Xilly-the-Honorable/beetledash/firmware_assets/beetle_front_worried.png

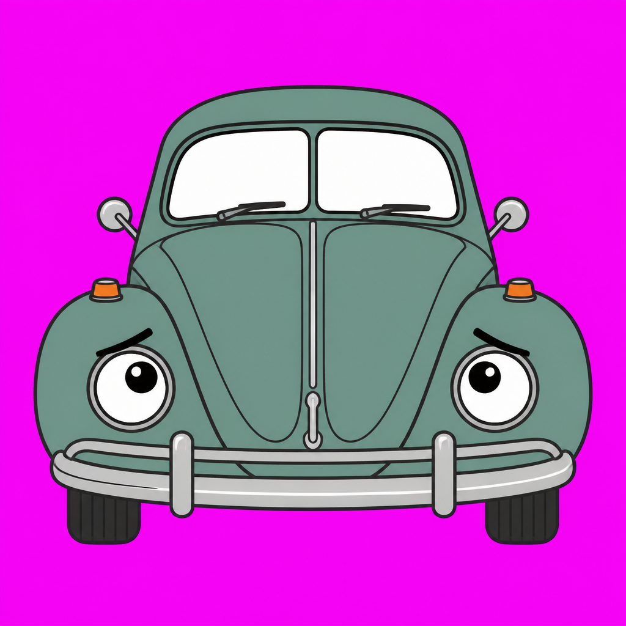
firmware_assets/beetle_front_worried.png
