Xilly-the-Honorable/beetledash/firmware_assets/beetle_lightning.png

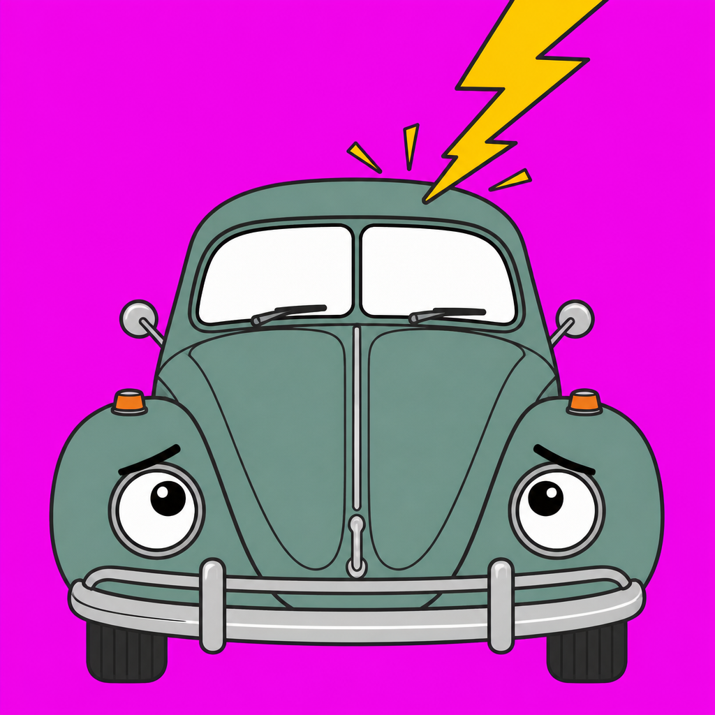
firmware_assets/beetle_lightning.png
