Xilly-the-Honorable/beetledash/firmware_assets/kienzle_face.png

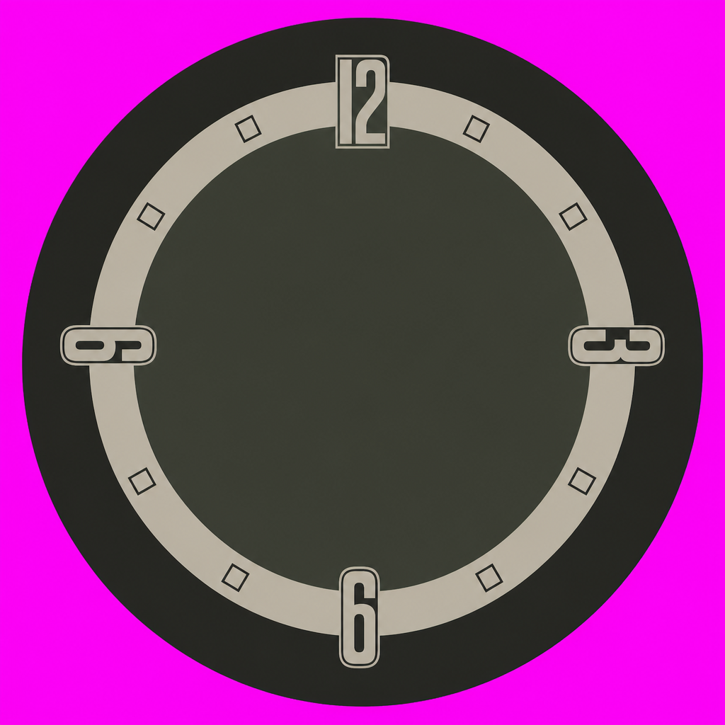
firmware_assets/kienzle_face.png
