Xilly-the-Honorable/beetledash/firmware/BeetleDash_V2_display/Gauge_UI.cpp

#include "Gauge_UI.h"
#include "Config.h"
#include <lvgl.h>
#include <math.h>
#include <esp_heap_caps.h>

extern const lv_img_dsc_t beetle_icon;          // beetle_icon.c (A8 silhouette, recolored at runtime)
extern const lv_img_dsc_t beetle_front_worried; // beetle_front_worried.c (low-fuel alert mascot)
extern const lv_img_dsc_t beetle_lightning;     // beetle_lightning.c (low-voltage alert mascot)
extern const lv_img_dsc_t kienzle_face;         // kienzle_face.c (pre-rendered Kienzle clock face)

// ---------- Palette: 1965 VW/VDO instrument family (docs/V3_vintage_ui_brief.md §0) ----------
#define COL_FACE      0x141414   // matte near-black gauge face
#define COL_BEZEL     0xC9CDD1   // chrome outer ring
#define COL_BEZEL_SHD 0x5A5E62   // thin inner shadow ring
#define COL_CREAM     0xEDE6D6   // aged-white markings/needles (never pure white)
#define COL_SAGE      0xC9CFC0   // classic VDO grey-green numerals
#define COL_FAINT     0x6B6B60   // dimmed cream for secondary text
#define COL_TRACK     0x2A2A26   // unlit scale track
#define COL_RED       0xB3352C   // vintage red (muted)
#define COL_AMBER     0xC98A2C   // muted amber
#define COL_GREEN     0x3E6B4F   // muted green band
#define COL_ORANGE    0xE8930C   // instrument orange (compass only)
#define COL_YELLOW    0xE8C43C   // amber/yellow cardinal letters
#define COL_HUB_SILVER 0xB9BDC1  // speedo-style silver hub cap
#define COL_HUB_DARK  0x1A1A1A   // volt-style dark hub cap
#define COL_DOT_OFF   0x3A3A3A   // inactive page dot

// Legacy aliases used by the not-yet-restyled screens (removed as milestones land)
#define COL_BG      COL_FACE
#define COL_CARD    COL_TRACK
#define COL_TEXT    COL_CREAM
#define COL_MUTED   COL_SAGE

#define BEZEL_W       8          // chrome ring width
#define BEZEL_SHD_W   6          // shadow ring width

#define SCREEN_COUNT 6

static gauge_data_provider_t dataProvider = NULL;

static lv_obj_t *tileview;
static lv_obj_t *dots[SCREEN_COUNT];

// Fuel screen (Störk-style round dial, dual liters/gallons scale)
static lv_obj_t *fuelMeter, *fuelDigital, *fuelAlert;
static lv_obj_t *fuelEyeL, *fuelEyeR;    // blinking headlight overlays on the mascot
static lv_meter_indicator_t *fuelNeedleL, *fuelNeedleR;   // two ends of one center-pivot needle
static lv_meter_scale_t *fuelScaleL, *fuelScaleGal;
#define COL_MINT 0xA8D4A0   // pale Störk green (markings, numerals, needle)
#define FUEL_ALERT_BELOW 25.0f   // show the "LOW FUEL" alert under this %
#define COL_LAMP  0xFFD84A       // lit-headlight yellow (alert only)
// Speed screen (VDO speedometer)
static lv_obj_t *speedMeter, *speedDigital, *speedSats;
static lv_meter_indicator_t *speedNeedle;
// Volts screen (VDO voltmeter)
static lv_obj_t *voltMeter, *voltDigital, *voltAlert;
static lv_meter_indicator_t *voltNeedle;
// Clock screen (vintage VDO dash clock)
static lv_obj_t *clockMeter, *clockValue, *clockSub;
static lv_meter_indicator_t *clockHourHand, *clockMinHand;
// Compass screen (aviation direction indicator)
static lv_obj_t *compassCard, *compassReadout;
// Brakes screen (dual-circuit status)
static lv_obj_t *brakeLamp1, *brakeLamp2, *brakeVerdict, *brakeVerdictLabel, *brakeSubLabel;

static const char *CARDINALS[8] = {"N", "NE", "E", "SE", "S", "SW", "W", "NW"};

// ============================================================
//  Small helpers
// ============================================================
// Tile indices (order of make_tile calls in Gauge_UI_Init)
#define TILE_FUEL    0
#define TILE_SPEED   1
#define TILE_VOLTS   2
#define TILE_CLOCK   3
#define TILE_COMPASS 4
#define TILE_BRAKES  5

// Alerts call this on their rising edge so the screen jumps to the gauge that
// raised them (the user can still swipe away while the alert stays up).
static void jump_to_tile(int idx)
{
  lv_obj_set_tile_id(tileview, idx, 0, LV_ANIM_OFF);
}

// Tap anywhere on a gauge -> jump to the next screen (wraps around).
// A drag still swipes: LVGL suppresses CLICKED once a gesture turns into a scroll.
// No animation: a single redraw beats the sluggish full-screen scroll on this panel.
static void tile_tap_cb(lv_event_t *e)
{
  int idx = (int)(intptr_t)lv_event_get_user_data(e);
  lv_obj_set_tile_id(tileview, (idx + 1) % SCREEN_COUNT, 0, LV_ANIM_OFF);
}

static lv_obj_t *make_tile(int idx)
{
  lv_obj_t *tile = lv_tileview_add_tile(tileview, idx, 0, LV_DIR_HOR);
  lv_obj_set_style_bg_color(tile, lv_color_hex(COL_BG), 0);
  lv_obj_set_style_bg_opa(tile, LV_OPA_COVER, 0);
  lv_obj_add_event_cb(tile, tile_tap_cb, LV_EVENT_CLICKED, (void *)(intptr_t)idx);
  return tile;
}

static lv_obj_t *make_label(lv_obj_t *parent, const lv_font_t *font, uint32_t color,
                            lv_align_t align, lv_coord_t x, lv_coord_t y, const char *text)
{
  lv_obj_t *l = lv_label_create(parent);
  lv_obj_set_style_text_font(l, font, 0);
  lv_obj_set_style_text_color(l, lv_color_hex(color), 0);
  lv_label_set_text(l, text);
  lv_obj_align(l, align, x, y);
  return l;
}

// Plain circle (used for bezel rings, hubs, markers)
static lv_obj_t *make_circle(lv_obj_t *parent, lv_coord_t d, uint32_t fill)
{
  lv_obj_t *c = lv_obj_create(parent);
  lv_obj_set_size(c, d, d);
  lv_obj_set_style_radius(c, LV_RADIUS_CIRCLE, 0);
  lv_obj_set_style_bg_color(c, lv_color_hex(fill), 0);
  lv_obj_set_style_bg_opa(c, LV_OPA_COVER, 0);
  lv_obj_set_style_border_width(c, 0, 0);
  lv_obj_set_style_pad_all(c, 0, 0);
  lv_obj_clear_flag(c, LV_OBJ_FLAG_CLICKABLE | LV_OBJ_FLAG_SCROLLABLE);
  lv_obj_center(c);
  return c;
}

// Chrome bezel: outer chrome ring -> thin shadow ring -> matte face.
// Concentric filled circles, drawn once, everything else goes on top.
static void make_bezel(lv_obj_t *tile)
{
  make_circle(tile, LV_HOR_RES, COL_BEZEL);
  make_circle(tile, LV_HOR_RES - 2 * BEZEL_W, COL_BEZEL_SHD);
  make_circle(tile, LV_HOR_RES - 2 * (BEZEL_W + BEZEL_SHD_W), COL_FACE);
}

// Letter-spaced caption ("TANK", "VOLTS", "MPH", ...)
static lv_obj_t *make_caption(lv_obj_t *parent, const char *text, lv_align_t align,
                              lv_coord_t x, lv_coord_t y)
{
  lv_obj_t *l = make_label(parent, &lv_font_montserrat_20, COL_CREAM, align, x, y, text);
  lv_obj_set_style_text_letter_space(l, 6, 0);
  return l;
}

// Tiny period wordmark near the bottom of every face
static void make_wordmark(lv_obj_t *tile)
{
  lv_obj_t *l = make_label(tile, &lv_font_montserrat_12, COL_FAINT,
                           LV_ALIGN_BOTTOM_MID, 0, -52, "BEETLEDASH");
  lv_obj_set_style_text_letter_space(l, 4, 0);
}

// Digital readout color state: muted red low, cream normal, muted amber high.
static uint32_t volt_text_color(float v)
{
  if (v < VOLT_LOW_BELOW)  return COL_RED;
  if (v > VOLT_HIGH_ABOVE) return COL_AMBER;
  return COL_CREAM;
}

// Bare meter: no background, no border — just scale, ticks, and needle.
static lv_obj_t *make_bare_meter(lv_obj_t *parent, lv_coord_t size)
{
  lv_obj_t *m = lv_meter_create(parent);
  lv_obj_set_size(m, size, size);
  lv_obj_set_style_bg_opa(m, LV_OPA_TRANSP, 0);
  lv_obj_set_style_border_width(m, 0, 0);
  lv_obj_set_style_pad_all(m, 0, 0);
  lv_obj_clear_flag(m, LV_OBJ_FLAG_CLICKABLE | LV_OBJ_FLAG_SCROLLABLE);
  return m;
}

// Needle hub: volt-style dark cap with a thin chrome edge, or silver speedo cap.
static void make_hub(lv_obj_t *tile, lv_coord_t d, lv_coord_t x, lv_coord_t y, bool silver)
{
  lv_obj_t *hub = make_circle(tile, d, silver ? COL_HUB_SILVER : COL_HUB_DARK);
  if (!silver) {
    lv_obj_set_style_border_width(hub, 2, 0);
    lv_obj_set_style_border_color(hub, lv_color_hex(COL_BEZEL), 0);
  }
  lv_obj_align(hub, LV_ALIGN_CENTER, x, y);
}

// ============================================================
//  Screen builders
// ============================================================
// Störk-style fuel gauge (per the dual °C/°F oil gauge reference): the needle
// is a full diameter line pivoting at DEAD CENTER, and its two ends read two
// mirrored half-scales — LITERS on the left (40 L at bottom-left when full,
// 0 L at top-left) and US GALLONS on the right (full = 10.6 gal at top-right,
// 0 at bottom-right). Implemented as two 180°-opposed needle indicators on
// hidden scales, driven together. The visible tick scales run "reversed"
// (values increase clockwise) so labels are rewritten in the draw callback.
static void fuel_tick_cb(lv_event_t *e)
{
  lv_obj_draw_part_dsc_t *dsc = lv_event_get_draw_part_dsc(e);
  if (dsc->type != LV_METER_DRAW_PART_TICK || !dsc->text) return;

  static char buf[8];
  if (dsc->sub_part_ptr == fuelScaleGal)
    lv_snprintf(buf, sizeof(buf), "%d", 10 - (int)dsc->value / 2);   // half-gallon units
  else
    lv_snprintf(buf, sizeof(buf), "%d", 40 - (int)dsc->value);       // liters
  dsc->text = buf;
}

static void build_fuel(lv_obj_t *tile)
{
  make_bezel(tile);
  lv_obj_t *cap = make_label(tile, &lv_font_montserrat_24, COL_MINT,
                             LV_ALIGN_CENTER, 0, -120, "TANK");
  lv_obj_set_style_text_letter_space(cap, 6, 0);

  fuelMeter = make_bare_meter(tile, 430);
  lv_obj_center(fuelMeter);

  lv_obj_set_style_text_font(fuelMeter, &lv_font_montserrat_24, LV_PART_TICKS);
  lv_obj_set_style_text_color(fuelMeter, lv_color_hex(COL_MINT), LV_PART_TICKS);
  lv_obj_add_event_cb(fuelMeter, fuel_tick_cb, LV_EVENT_DRAW_PART_BEGIN, NULL);

  // LEFT half — liters. Bottom-left (135°) to top-left (225°); tick values
  // 0..40 clockwise, labels reversed to 40..0 so 40 L sits at bottom-left.
  // Minors every 2 L, majors every 10 L.
  fuelScaleL = lv_meter_add_scale(fuelMeter);
  lv_meter_set_scale_range(fuelMeter, fuelScaleL, 0, 40, 90, 135);
  lv_meter_set_scale_ticks(fuelMeter, fuelScaleL, 21, 3, 14, lv_color_hex(COL_MINT));
  lv_meter_set_scale_major_ticks(fuelMeter, fuelScaleL, 5, 5, 24, lv_color_hex(COL_MINT), 24);

  // RIGHT half — gallons, whole numbers only. Full tank = 10.6 gal at
  // top-right (315°), empty at bottom-right (45°). The integer ticks 10..0
  // occupy 90° * 10/10.6 ≈ 85°, starting at 320° (the "10" mark sits just
  // shy of where the full needle points). Values in half-gallons (0..20
  // clockwise), labels reversed. Minors every 0.5 gal, majors every 2 gal.
  fuelScaleGal = lv_meter_add_scale(fuelMeter);
  lv_meter_set_scale_range(fuelMeter, fuelScaleGal, 0, 20, 85, 320);
  lv_meter_set_scale_ticks(fuelMeter, fuelScaleGal, 21, 3, 14, lv_color_hex(COL_MINT));
  lv_meter_set_scale_major_ticks(fuelMeter, fuelScaleGal, 4, 5, 24, lv_color_hex(COL_MINT), 24);

  // Red reserve wedge on the liters side (last ~12% ≈ under 5 L, near top-left)
  lv_meter_indicator_t *reserve = lv_meter_add_arc(fuelMeter, fuelScaleL, 6, lv_color_hex(COL_RED), 0);
  lv_meter_set_indicator_start_value(fuelMeter, reserve, 35);
  lv_meter_set_indicator_end_value(fuelMeter, reserve, 40);

  // Needle = two ends of one center-pivot line, on hidden 0..1000 (permille,
  // empty..full reversed) scales 180° apart. Value 0 = full, 1000 = empty.
  lv_meter_scale_t *nL = lv_meter_add_scale(fuelMeter);
  lv_meter_set_scale_range(fuelMeter, nL, 0, 1000, 90, 135);   // full: bottom-left
  lv_meter_set_scale_ticks(fuelMeter, nL, 0, 0, 0, lv_color_black());
  lv_meter_scale_t *nR = lv_meter_add_scale(fuelMeter);
  lv_meter_set_scale_range(fuelMeter, nR, 0, 1000, 90, 315);   // full: top-right
  lv_meter_set_scale_ticks(fuelMeter, nR, 0, 0, 0, lv_color_black());
  fuelNeedleL = lv_meter_add_needle_line(fuelMeter, nL, 5, lv_color_hex(COL_MINT), -14);
  fuelNeedleR = lv_meter_add_needle_line(fuelMeter, nR, 5, lv_color_hex(COL_MINT), -14);
  lv_meter_set_indicator_value(fuelMeter, fuelNeedleL, 1000);
  lv_meter_set_indicator_value(fuelMeter, fuelNeedleR, 1000);

  make_hub(tile, 44, 0, 0, false);                            // black cap, chrome edge

  // Unit labels under each half-scale, like the °C / °F on the original
  make_label(tile, &lv_font_montserrat_16, COL_MINT, LV_ALIGN_CENTER, -118, 148, "L");
  make_label(tile, &lv_font_montserrat_16, COL_MINT, LV_ALIGN_CENTER, 118, 148, "GAL");
  // Liters remaining, below the hub
  fuelDigital = make_label(tile, &lv_font_montserrat_24, COL_MINT, LV_ALIGN_CENTER, 0, 78, "-- L");

  // "LOW FUEL" alert: yellow panel, dark text, worried beetle — replaces the
  // digital liters readout when low (same styling as the low-voltage alert).
  fuelAlert = lv_obj_create(tile);
  lv_obj_set_size(fuelAlert, LV_SIZE_CONTENT, LV_SIZE_CONTENT);
  lv_obj_set_style_bg_color(fuelAlert, lv_color_hex(COL_YELLOW), 0);
  lv_obj_set_style_bg_opa(fuelAlert, LV_OPA_COVER, 0);
  lv_obj_set_style_radius(fuelAlert, 18, 0);
  lv_obj_set_style_border_width(fuelAlert, 0, 0);
  lv_obj_set_style_pad_all(fuelAlert, 14, 0);
  lv_obj_set_style_pad_column(fuelAlert, 14, 0);
  lv_obj_set_flex_flow(fuelAlert, LV_FLEX_FLOW_ROW);
  lv_obj_set_flex_align(fuelAlert, LV_FLEX_ALIGN_CENTER, LV_FLEX_ALIGN_CENTER, LV_FLEX_ALIGN_CENTER);
  lv_obj_clear_flag(fuelAlert, LV_OBJ_FLAG_CLICKABLE | LV_OBJ_FLAG_SCROLLABLE);

  lv_obj_t *alertText = lv_label_create(fuelAlert);
  lv_obj_set_style_text_font(alertText, &lv_font_montserrat_32, 0);
  lv_obj_set_style_text_color(alertText, lv_color_hex(COL_FACE), 0);   // dark on yellow
  lv_obj_set_style_text_letter_space(alertText, 2, 0);
  lv_label_set_text(alertText, "LOW\nFUEL");

  lv_obj_t *worried = lv_img_create(fuelAlert);
  lv_img_set_src(worried, &beetle_front_worried);

  // Headlight "flashers": yellow circles over the eyes (centers ~(22,63) and
  // (100,63) in the 122x100 art), blinked from refresh_cb while the alert shows.
  fuelEyeL = make_circle(worried, 20, COL_LAMP);
  fuelEyeR = make_circle(worried, 20, COL_LAMP);
  lv_obj_align(fuelEyeL, LV_ALIGN_TOP_LEFT, 12, 53);
  lv_obj_align(fuelEyeR, LV_ALIGN_TOP_LEFT, 90, 53);
  lv_obj_t *eyes[2] = { fuelEyeL, fuelEyeR };
  for (int i = 0; i < 2; i++) {
    lv_obj_set_style_border_width(eyes[i], 3, 0);
    lv_obj_set_style_border_color(eyes[i], lv_color_hex(COL_ORANGE), 0);
    lv_obj_set_style_opa(eyes[i], LV_OPA_TRANSP, 0);   // start dark
  }

  lv_obj_align(fuelAlert, LV_ALIGN_CENTER, 0, 6);
  lv_obj_add_flag(fuelAlert, LV_OBJ_FLAG_HIDDEN);

  make_wordmark(tile);
}

// 1965 VDO speedometer: 0–80 sage numerals, 0 at ~7 o'clock sweeping clockwise
// to 80 at ~5 o'clock, long cream needle on a silver hub.
static void build_speed(lv_obj_t *tile)
{
  make_bezel(tile);

  speedMeter = make_bare_meter(tile, 430);
  lv_obj_center(speedMeter);

  lv_meter_scale_t *sc = lv_meter_add_scale(speedMeter);
  lv_meter_set_scale_range(speedMeter, sc, 0, 80, 270, 135);    // 0 @ 7 o'clock → 80 @ 5 o'clock
  lv_meter_set_scale_ticks(speedMeter, sc, 17, 3, 14, lv_color_hex(COL_CREAM));      // every 5 mph
  lv_meter_set_scale_major_ticks(speedMeter, sc, 2, 6, 26, lv_color_hex(COL_CREAM), 24); // every 10
  lv_obj_set_style_text_font(speedMeter, &lv_font_montserrat_28, LV_PART_TICKS);
  lv_obj_set_style_text_color(speedMeter, lv_color_hex(COL_SAGE), LV_PART_TICKS);    // sage numerals

  speedNeedle = lv_meter_add_needle_line(speedMeter, sc, 6, lv_color_hex(COL_CREAM), -14);
  lv_meter_set_indicator_value(speedMeter, speedNeedle, 0);

  make_hub(tile, 64, 0, 0, true);                               // silver speedo hub
  make_caption(tile, "MPH", LV_ALIGN_CENTER, 0, 72);
  speedDigital = make_label(tile, &lv_font_montserrat_28, COL_CREAM, LV_ALIGN_CENTER, 0, 118, "--");
  speedSats = make_label(tile, &lv_font_montserrat_14, COL_FAINT, LV_ALIGN_CENTER, 0, 152, "acquiring fix...");
  make_wordmark(tile);
}

// VDO voltmeter: 8–16 V scale (decivolt units internally), colored bands on the
// arc, needle from a lower-center pivot, live digital readout under the hub.
static void volt_tick_label_cb(lv_event_t *e)
{
  lv_obj_draw_part_dsc_t *dsc = lv_event_get_draw_part_dsc(e);
  if (dsc->type != LV_METER_DRAW_PART_TICK || dsc->text == NULL) return;
  static char buf[8];                       // LVGL draws each label before the next event
  lv_snprintf(buf, sizeof(buf), "%d", (int)(dsc->value / 10));
  dsc->text = buf;
}

static void build_volts(lv_obj_t *tile)
{
  make_bezel(tile);

  const lv_coord_t msize = 540, pivotY = 340;
  voltMeter = make_bare_meter(tile, msize);
  lv_obj_set_pos(voltMeter, 240 - msize / 2, pivotY - msize / 2);

  lv_meter_scale_t *sc = lv_meter_add_scale(voltMeter);
  lv_meter_set_scale_range(voltMeter, sc, 80, 160, 120, 210);   // 8–16 V over 120° up top
  lv_meter_set_scale_ticks(voltMeter, sc, 9, 3, 16, lv_color_hex(COL_CREAM));        // every 1 V
  lv_meter_set_scale_major_ticks(voltMeter, sc, 2, 6, 28, lv_color_hex(COL_CREAM), 28); // 8·10·12·14·16
  lv_obj_set_style_text_font(voltMeter, &lv_font_montserrat_24, LV_PART_TICKS);
  lv_obj_set_style_text_color(voltMeter, lv_color_hex(COL_CREAM), LV_PART_TICKS);
  lv_obj_add_event_cb(voltMeter, volt_tick_label_cb, LV_EVENT_DRAW_PART_BEGIN, NULL);

  // Colored bands on the scale arc (like the reference): red 8–10.5,
  // amber transition 10.5–11.5, muted green 11.5–16.
  struct { int from, to; uint32_t col; } bands[] = {
    {80, 105, COL_RED}, {105, 115, COL_AMBER}, {115, 160, COL_GREEN},
  };
  for (auto &b : bands) {
    lv_meter_indicator_t *arc = lv_meter_add_arc(voltMeter, sc, 10, lv_color_hex(b.col), 0);
    lv_meter_set_indicator_start_value(voltMeter, arc, b.from);
    lv_meter_set_indicator_end_value(voltMeter, arc, b.to);
  }

  voltNeedle = lv_meter_add_needle_line(voltMeter, sc, 6, lv_color_hex(COL_CREAM), -36);
  lv_meter_set_indicator_value(voltMeter, voltNeedle, 120);

  make_hub(tile, 56, 0, pivotY - 240, false);
  make_caption(tile, "VOLTS", LV_ALIGN_CENTER, 78, -24);        // right-of-center, like the reference

  // Live digital readout under the hub — hard requirement.
  voltDigital = make_label(tile, &lv_font_montserrat_28, COL_CREAM, LV_ALIGN_CENTER, 0, 150, "--.-");
  make_label(tile, &lv_font_montserrat_14, COL_FAINT, LV_ALIGN_CENTER, 52, 154, "V");

  // "LOW VOLTAGE" alert: yellow panel, dark text, lightning-struck beetle.
  // Suppressed for the first minute after boot (startup voltage sag).
  voltAlert = lv_obj_create(tile);
  lv_obj_set_size(voltAlert, LV_SIZE_CONTENT, LV_SIZE_CONTENT);
  lv_obj_set_style_bg_color(voltAlert, lv_color_hex(COL_YELLOW), 0);
  lv_obj_set_style_bg_opa(voltAlert, LV_OPA_COVER, 0);
  lv_obj_set_style_radius(voltAlert, 18, 0);
  lv_obj_set_style_border_width(voltAlert, 0, 0);
  lv_obj_set_style_pad_all(voltAlert, 14, 0);
  lv_obj_set_style_pad_column(voltAlert, 14, 0);
  lv_obj_set_flex_flow(voltAlert, LV_FLEX_FLOW_ROW);
  lv_obj_set_flex_align(voltAlert, LV_FLEX_ALIGN_CENTER, LV_FLEX_ALIGN_CENTER, LV_FLEX_ALIGN_CENTER);
  lv_obj_clear_flag(voltAlert, LV_OBJ_FLAG_CLICKABLE | LV_OBJ_FLAG_SCROLLABLE);

  lv_obj_t *vText = lv_label_create(voltAlert);
  lv_obj_set_style_text_font(vText, &lv_font_montserrat_32, 0);
  lv_obj_set_style_text_color(vText, lv_color_hex(COL_FACE), 0);   // dark on yellow
  lv_obj_set_style_text_letter_space(vText, 2, 0);
  lv_label_set_text(vText, "LOW\nVOLTAGE");

  lv_obj_t *struck = lv_img_create(voltAlert);
  lv_img_set_src(struck, &beetle_lightning);

  lv_obj_align(voltAlert, LV_ALIGN_CENTER, 0, -10);
  lv_obj_add_flag(voltAlert, LV_OBJ_FLAG_HIDDEN);
  make_wordmark(tile);
}

// Kienzle-style VW dash clock: the face (ring band, sideways 3/9, deco
// numerals, square hour markers) is a pre-rendered bitmap generated from the
// reference photos — LVGL can't rotate label glyphs, and the sideways quarter
// numerals are the signature of this clock. Hands, hub and the digital HH:MM
// (in the "8 TAGE" spot) are still drawn live on top.
#define COL_BRASS 0xC5A05A   // gold-brass hands

static void build_clock(lv_obj_t *tile)
{
  make_bezel(tile);

  lv_obj_t *face = lv_img_create(tile);
  lv_img_set_src(face, &kienzle_face);
  lv_obj_center(face);

  // Meter only carries the two hands (scales invisible)
  clockMeter = make_bare_meter(tile, 430);
  lv_obj_center(clockMeter);
  lv_meter_scale_t *scMin = lv_meter_add_scale(clockMeter);
  lv_meter_set_scale_range(clockMeter, scMin, 0, 60, 360, 270);   // 0 (=12) at the top
  lv_meter_set_scale_ticks(clockMeter, scMin, 0, 0, 0, lv_color_black());
  lv_meter_scale_t *scHour = lv_meter_add_scale(clockMeter);     // smooth hour hand
  lv_meter_set_scale_range(clockMeter, scHour, 0, 720, 360, 270);
  lv_meter_set_scale_ticks(clockMeter, scHour, 0, 0, 0, lv_color_black());

  // Tips sized to the bitmap face: minute reaches into the ring band
  // (~r145), hour stops short of the numerals (~r105).
  clockMinHand  = lv_meter_add_needle_line(clockMeter, scMin,  5, lv_color_hex(COL_BRASS), -67);
  clockHourHand = lv_meter_add_needle_line(clockMeter, scHour, 8, lv_color_hex(COL_BRASS), -110);
  lv_meter_set_indicator_value(clockMeter, clockMinHand, 0);
  lv_meter_set_indicator_value(clockMeter, clockHourHand, 0);

  make_hub(tile, 32, 0, 0, false);

  // Digital HH:MM in the "8 TAGE" spot; GPS status line mirrored above the hub
  clockValue = make_label(tile, &lv_font_montserrat_20, COL_CREAM, LV_ALIGN_CENTER, 0, 88, "--:--");
  lv_obj_set_style_text_letter_space(clockValue, 3, 0);
  clockSub = make_label(tile, &lv_font_montserrat_14, COL_FAINT, LV_ALIGN_CENTER, 0, -92, "waiting for GPS time");
  make_wordmark(tile);
}

// Aviation direction indicator: the card (ticks + numerals + cardinals) is drawn
// ONCE onto a canvas in PSRAM, then rotated as a whole with lv_img_set_angle()
// (card angle = -heading). The beetle icon and lubber line stay fixed on top.
#define CARD_SIZE 420
#define CARD_C    (CARD_SIZE / 2)

static void draw_compass_card(lv_obj_t *canvas)
{
  lv_canvas_fill_bg(canvas, lv_color_black(), LV_OPA_TRANSP);

  lv_draw_line_dsc_t ld;
  lv_draw_line_dsc_init(&ld);
  ld.color = lv_color_hex(COL_CREAM);

  for (int deg = 0; deg < 360; deg += 5) {
    bool major = (deg % 10) == 0;
    ld.width = major ? 3 : 2;
    float a = deg * (float)M_PI / 180.0f;
    float sx = sinf(a), cy = -cosf(a);
    lv_coord_t r1 = CARD_C - 2, r2 = CARD_C - (major ? 22 : 13);
    lv_point_t pts[2] = {
      { (lv_coord_t)(CARD_C + r1 * sx), (lv_coord_t)(CARD_C + r1 * cy) },
      { (lv_coord_t)(CARD_C + r2 * sx), (lv_coord_t)(CARD_C + r2 * cy) },
    };
    lv_canvas_draw_line(canvas, pts, 2, &ld);
  }

  // Numerals every 30°: N/E/S/W in amber at the cardinals, tens-of-degrees
  // (3, 6, 12, 15, 21, 24, 30, 33) in cream between them.
  lv_draw_label_dsc_t td;
  lv_draw_label_dsc_init(&td);
  td.align = LV_TEXT_ALIGN_CENTER;
  const lv_coord_t rText = CARD_C - 52;
  for (int i = 0; i < 12; i++) {
    int deg = i * 30;
    bool cardinal = (deg % 90) == 0;
    td.font  = cardinal ? &lv_font_montserrat_28 : &lv_font_montserrat_24;
    td.color = lv_color_hex(cardinal ? COL_YELLOW : COL_CREAM);
    char buf[4];
    if (cardinal) buf[0] = "NESW"[deg / 90], buf[1] = '\0';
    else          lv_snprintf(buf, sizeof(buf), "%d", deg / 10);
    float a = deg * (float)M_PI / 180.0f;
    lv_coord_t x = (lv_coord_t)(CARD_C + rText * sinf(a));
    lv_coord_t y = (lv_coord_t)(CARD_C - rText * cosf(a));
    lv_canvas_draw_text(canvas, x - 40, y - 16, 80, &td, buf);
  }
}

static void build_compass(lv_obj_t *tile)
{
  make_bezel(tile);

  // Card canvas lives in PSRAM (ARGB, ~530 KB) — drawn once, rotated per update.
  static lv_color_t *cardBuf = NULL;
  if (cardBuf == NULL)
    cardBuf = (lv_color_t *)heap_caps_malloc(
        LV_CANVAS_BUF_SIZE_TRUE_COLOR_ALPHA(CARD_SIZE, CARD_SIZE), MALLOC_CAP_SPIRAM);

  compassCard = lv_canvas_create(tile);
  lv_canvas_set_buffer(compassCard, cardBuf, CARD_SIZE, CARD_SIZE, LV_IMG_CF_TRUE_COLOR_ALPHA);
  lv_obj_center(compassCard);
  draw_compass_card(compassCard);
  lv_img_set_pivot(compassCard, CARD_C, CARD_C);

  // Fixed beetle silhouette, instrument orange, nose up — the card turns around it.
  lv_obj_t *ic = lv_img_create(tile);
  lv_img_set_src(ic, &beetle_icon);
  lv_obj_set_style_img_recolor(ic, lv_color_hex(COL_ORANGE), 0);
  lv_obj_set_style_img_recolor_opa(ic, LV_OPA_COVER, 0);
  lv_img_set_zoom(ic, 230);                     // 200 px tall art → ~180 px (~40% of face)
  lv_obj_center(ic);

  // Fixed orange lubber line at 12 o'clock, over the card edge.
  lv_obj_t *lubber = lv_obj_create(tile);
  lv_obj_set_size(lubber, 6, 30);
  lv_obj_set_style_bg_color(lubber, lv_color_hex(COL_ORANGE), 0);
  lv_obj_set_style_bg_opa(lubber, LV_OPA_COVER, 0);
  lv_obj_set_style_border_width(lubber, 0, 0);
  lv_obj_set_style_radius(lubber, 2, 0);
  lv_obj_clear_flag(lubber, LV_OBJ_FLAG_CLICKABLE | LV_OBJ_FLAG_SCROLLABLE);
  lv_obj_align(lubber, LV_ALIGN_CENTER, 0, -(CARD_C - 12));

  compassReadout = make_label(tile, &lv_font_montserrat_24, COL_CREAM, LV_ALIGN_CENTER, 0, 146, "---");
  make_wordmark(tile);
}

// Dual-circuit brake status: two vintage "idiot light" lamps (lit while that
// circuit has pressure — pressing the pedal lights both, the built-in self-test)
// plus a big OK / NOT OK verdict lamp for the latched-fault state.
static lv_obj_t *make_lamp(lv_obj_t *tile, lv_coord_t d, lv_coord_t x, lv_coord_t y)
{
  lv_obj_t *lamp = make_circle(tile, d, COL_HUB_DARK);
  lv_obj_set_style_border_width(lamp, 4, 0);
  lv_obj_set_style_border_color(lamp, lv_color_hex(COL_HUB_SILVER), 0);  // chrome rim
  lv_obj_align(lamp, LV_ALIGN_CENTER, x, y);
  return lamp;
}

static void build_brakes(lv_obj_t *tile)
{
  make_bezel(tile);
  make_caption(tile, "BRAKES", LV_ALIGN_TOP_MID, 0, 56);

  make_label(tile, &lv_font_montserrat_24, COL_CREAM, LV_ALIGN_CENTER, -70, -130, "C1");
  make_label(tile, &lv_font_montserrat_24, COL_CREAM, LV_ALIGN_CENTER,  70, -130, "C2");
  brakeLamp1 = make_lamp(tile, 96, -70, -55);
  brakeLamp2 = make_lamp(tile, 96,  70, -55);

  brakeVerdict = make_lamp(tile, 124, 0, 80);
  lv_obj_set_style_bg_color(brakeVerdict, lv_color_hex(COL_GREEN), 0);
  brakeVerdictLabel = make_label(brakeVerdict, &lv_font_montserrat_24, COL_CREAM,
                                 LV_ALIGN_CENTER, 0, 0, "OK");

  // Dual-use line: faint self-test hint normally, red fault name when latched
  brakeSubLabel = make_label(tile, &lv_font_montserrat_16, COL_FAINT,
                             LV_ALIGN_CENTER, 0, 152, "press pedal to test");
  make_wordmark(tile);
}

// ============================================================
//  Brake fault alert (V4) — full-screen overlay + acknowledged banner.
//  Lives on lv_layer_top() so it superposes any tile; created AFTER the page
//  dots so it covers them. The overlay eats all touch input.
// ============================================================
static lv_obj_t *brakeOverlay, *brakeOverlayLine2, *brakeBanner, *brakeBannerLabel;
static uint8_t brakeShownFault = BRAKE_FAULT_NONE;  // fault the overlay/banner displays
static uint8_t brakeAcked = BRAKE_FAULT_NONE;       // fault already acknowledged to banner
static uint32_t bannerPressStart = 0;               // 3 s long-press-to-clear tracking

static void brake_overlay_click_cb(lv_event_t *e)
{
  // Acknowledge: collapse the overlay to the persistent banner.
  brakeAcked = brakeShownFault;
  lv_obj_add_flag(brakeOverlay, LV_OBJ_FLAG_HIDDEN);
  lv_label_set_text_fmt(brakeBannerLabel, "BRAKE FAULT C%d", brakeAcked);
  lv_obj_clear_flag(brakeBanner, LV_OBJ_FLAG_HIDDEN);
}

static void brake_banner_press_cb(lv_event_t *e)
{
  lv_event_code_t code = lv_event_get_code(e);
  if (code == LV_EVENT_PRESSED) bannerPressStart = lv_tick_get();
  else bannerPressStart = 0;   // RELEASED or PRESS_LOST
}

static void build_brake_alert(void)
{
  // Full-screen loud overlay
  brakeOverlay = lv_obj_create(lv_layer_top());
  lv_obj_set_size(brakeOverlay, LV_HOR_RES, LV_VER_RES);
  lv_obj_set_pos(brakeOverlay, 0, 0);
  lv_obj_set_style_radius(brakeOverlay, LV_RADIUS_CIRCLE, 0);
  lv_obj_set_style_bg_color(brakeOverlay, lv_color_hex(COL_FACE), 0);
  lv_obj_set_style_bg_opa(brakeOverlay, LV_OPA_COVER, 0);
  lv_obj_set_style_border_width(brakeOverlay, 14, 0);
  lv_obj_set_style_border_color(brakeOverlay, lv_color_hex(COL_RED), 0);
  lv_obj_clear_flag(brakeOverlay, LV_OBJ_FLAG_SCROLLABLE);
  lv_obj_add_flag(brakeOverlay, LV_OBJ_FLAG_CLICKABLE);   // eats taps AND swipes
  lv_obj_add_event_cb(brakeOverlay, brake_overlay_click_cb, LV_EVENT_CLICKED, NULL);

  lv_obj_t *word = make_label(brakeOverlay, &lv_font_montserrat_48, COL_CREAM,
                              LV_ALIGN_CENTER, 0, -70, "BRAKE");
  lv_obj_set_style_text_letter_space(word, 10, 0);
  brakeOverlayLine2 = make_label(brakeOverlay, &lv_font_montserrat_28, COL_CREAM,
                                 LV_ALIGN_CENTER, 0, 14, "CIRCUIT - FAILED");
  make_label(brakeOverlay, &lv_font_montserrat_16, COL_FAINT,
             LV_ALIGN_CENTER, 0, 92, "tap to acknowledge");
  lv_obj_add_flag(brakeOverlay, LV_OBJ_FLAG_HIDDEN);

  // Acknowledged: persistent red banner. y=56 + width 300 keeps it inside the
  // circular bezel chord (full-width at y=0 would be clipped by the round face).
  brakeBanner = lv_obj_create(lv_layer_top());
  lv_obj_set_size(brakeBanner, 300, 48);
  lv_obj_align(brakeBanner, LV_ALIGN_TOP_MID, 0, 56);
  lv_obj_set_style_radius(brakeBanner, 12, 0);
  lv_obj_set_style_bg_color(brakeBanner, lv_color_hex(COL_RED), 0);
  lv_obj_set_style_bg_opa(brakeBanner, LV_OPA_COVER, 0);
  lv_obj_set_style_border_width(brakeBanner, 0, 0);
  lv_obj_clear_flag(brakeBanner, LV_OBJ_FLAG_SCROLLABLE);
  lv_obj_add_flag(brakeBanner, LV_OBJ_FLAG_CLICKABLE);
  lv_obj_add_event_cb(brakeBanner, brake_banner_press_cb, LV_EVENT_PRESSED, NULL);
  lv_obj_add_event_cb(brakeBanner, brake_banner_press_cb, LV_EVENT_RELEASED, NULL);
  lv_obj_add_event_cb(brakeBanner, brake_banner_press_cb, LV_EVENT_PRESS_LOST, NULL);

  brakeBannerLabel = make_label(brakeBanner, &lv_font_montserrat_20, COL_CREAM,
                                LV_ALIGN_CENTER, 0, 0, "BRAKE FAULT C-");
  lv_obj_set_style_text_letter_space(brakeBannerLabel, 2, 0);
  lv_obj_add_flag(brakeBanner, LV_OBJ_FLAG_HIDDEN);
}

// Called from refresh_cb with the fresh snapshot: raises/blinks/clears the alert.
static void brake_sync(const GaugeData &d)
{
  if (d.brakeFault == BRAKE_FAULT_NONE) {
    // Fault gone (power-cycle semantics, long-press clear, or demo cycle ended)
    if (brakeShownFault != BRAKE_FAULT_NONE || brakeAcked != BRAKE_FAULT_NONE) {
      brakeShownFault = brakeAcked = BRAKE_FAULT_NONE;
      lv_obj_add_flag(brakeOverlay, LV_OBJ_FLAG_HIDDEN);
      lv_obj_add_flag(brakeBanner, LV_OBJ_FLAG_HIDDEN);
    }
    return;
  }

  if (d.brakeFault != brakeAcked) {
    // New (or different-circuit) fault: raise the full overlay
    if (d.brakeFault != brakeShownFault || lv_obj_has_flag(brakeOverlay, LV_OBJ_FLAG_HIDDEN)) {
      brakeShownFault = d.brakeFault;
      lv_label_set_text_fmt(brakeOverlayLine2, "CIRCUIT %d FAILED", d.brakeFault);
      lv_obj_clear_flag(brakeOverlay, LV_OBJ_FLAG_HIDDEN);
      lv_obj_add_flag(brakeBanner, LV_OBJ_FLAG_HIDDEN);
      jump_to_tile(TILE_BRAKES);   // acknowledging lands on the BRAKES status tile
    }
    // Blink the red border ring ~1 Hz (refresh runs every 100 ms)
    static uint8_t blink = 0;
    static bool ringOn = true;
    bool on = ((++blink / 5) & 1) == 0;
    if (on != ringOn) {
      ringOn = on;
      lv_obj_set_style_border_opa(brakeOverlay, on ? LV_OPA_COVER : LV_OPA_20, 0);
    }
  }

  // 3 s long-press on the banner = clear the latch (false-latch escape hatch)
  if (bannerPressStart != 0 && lv_tick_elaps(bannerPressStart) >= 3000) {
    bannerPressStart = 0;
    Sensors_ClearBrakeFault();
    brakeShownFault = brakeAcked = BRAKE_FAULT_NONE;
    lv_obj_add_flag(brakeBanner, LV_OBJ_FLAG_HIDDEN);
  }
}

// ============================================================
//  Boot sequence — splash, then a factory-style gauge self-test:
//  the display tours all six screens, sweeping each needle to max and back.
// ============================================================
#define SPLASH_MS     1200   // wordmark splash duration
#define BOOT_DWELL_MS  500   // per-screen dwell during the sweep tour

static lv_obj_t *splash;

static void build_splash(void)
{
  splash = lv_obj_create(lv_layer_top());
  lv_obj_set_size(splash, LV_HOR_RES, LV_VER_RES);
  lv_obj_set_pos(splash, 0, 0);
  lv_obj_set_style_bg_color(splash, lv_color_hex(COL_FACE), 0);
  lv_obj_set_style_bg_opa(splash, LV_OPA_COVER, 0);
  lv_obj_set_style_border_width(splash, 0, 0);
  lv_obj_set_style_pad_all(splash, 0, 0);
  lv_obj_clear_flag(splash, LV_OBJ_FLAG_SCROLLABLE);
  lv_obj_add_flag(splash, LV_OBJ_FLAG_CLICKABLE);   // eat touches while booting
  make_bezel(splash);

  lv_obj_t *ic = lv_img_create(splash);
  lv_img_set_src(ic, &beetle_icon);
  lv_obj_set_style_img_recolor(ic, lv_color_hex(COL_ORANGE), 0);
  lv_obj_set_style_img_recolor_opa(ic, LV_OPA_COVER, 0);
  lv_img_set_zoom(ic, 154);                         // 200 px art -> ~120 px
  lv_obj_align(ic, LV_ALIGN_CENTER, 0, -70);

  lv_obj_t *word = make_label(splash, &lv_font_montserrat_32, COL_CREAM,
                              LV_ALIGN_CENTER, 0, 46, "BEETLEDASH");
  lv_obj_set_style_text_letter_space(word, 8, 0);
  make_label(splash, &lv_font_montserrat_16, COL_SAGE, LV_ALIGN_CENTER, 0, 96, "V2.2");
}

// Runs from refresh_cb until it returns false; drives the visible tile's
// gauge with a 0 -> max -> 0 triangle sweep (compass spins a full turn,
// brake lamps flash) — the classic ignition needle test.
static bool boot_sequence(void)
{
  static uint32_t t0 = 0;
  static int lastIdx = -1;
  uint32_t now = millis();
  if (t0 == 0) t0 = now;
  uint32_t e = now - t0;

  if (e < SPLASH_MS) return true;
  if (!lv_obj_has_flag(splash, LV_OBJ_FLAG_HIDDEN))
    lv_obj_add_flag(splash, LV_OBJ_FLAG_HIDDEN);

  uint32_t te = e - SPLASH_MS;
  int idx = te / BOOT_DWELL_MS;
  if (idx >= SCREEN_COUNT) {
    jump_to_tile(TILE_FUEL);
    return false;                     // boot done, live data takes over
  }
  if (idx != lastIdx) { lastIdx = idx; jump_to_tile(idx); }

  float p = (te % BOOT_DWELL_MS) / (float)BOOT_DWELL_MS;         // 0..1 in dwell
  float tri = (p < 0.5f) ? p * 2.0f : (1.0f - p) * 2.0f;         // 0 -> 1 -> 0

  switch (idx) {
    case TILE_FUEL: {
      int v = 1000 - (int)(tri * 1000);   // hidden scales: 0 = full, 1000 = empty
      lv_meter_set_indicator_value(fuelMeter, fuelNeedleL, v);
      lv_meter_set_indicator_value(fuelMeter, fuelNeedleR, v);
      break;
    }
    case TILE_SPEED:
      lv_meter_set_indicator_value(speedMeter, speedNeedle, (int)(tri * 80));
      break;
    case TILE_VOLTS:
      lv_meter_set_indicator_value(voltMeter, voltNeedle, 80 + (int)(tri * 80));
      break;
    case TILE_CLOCK:
      lv_meter_set_indicator_value(clockMeter, clockMinHand, (int)(tri * 60));
      lv_meter_set_indicator_value(clockMeter, clockHourHand, (int)(tri * 720));
      break;
    case TILE_COMPASS:
      lv_img_set_angle(compassCard, (int)(p * 3600.0f) % 3600);  // one full spin
      break;
    case TILE_BRAKES: {
      uint32_t lamp = (tri > 0.5f) ? COL_YELLOW : COL_HUB_DARK;
      lv_obj_set_style_bg_color(brakeLamp1, lv_color_hex(lamp), 0);
      lv_obj_set_style_bg_color(brakeLamp2, lv_color_hex(lamp), 0);
      break;
    }
  }
  return true;
}

// ============================================================
//  Page dots
// ============================================================
static void update_dots(int active)
{
  for (int i = 0; i < SCREEN_COUNT; i++) {
    lv_obj_set_style_bg_color(dots[i], lv_color_hex(i == active ? COL_CREAM : COL_DOT_OFF), 0);
    lv_obj_set_size(dots[i], i == active ? 10 : 7, i == active ? 10 : 7);
  }
}

static void tile_changed_cb(lv_event_t *e)
{
  lv_obj_t *tile = lv_tileview_get_tile_act(tileview);
  update_dots(lv_obj_get_x(tile) / LV_HOR_RES);
}

static void build_dots(void)
{
  lv_obj_t *row = lv_obj_create(lv_layer_top());
  lv_obj_set_size(row, LV_SIZE_CONTENT, LV_SIZE_CONTENT);
  lv_obj_set_style_bg_opa(row, LV_OPA_TRANSP, 0);
  lv_obj_set_style_border_width(row, 0, 0);
  lv_obj_set_style_pad_all(row, 4, 0);
  lv_obj_set_style_pad_column(row, 10, 0);
  lv_obj_set_flex_flow(row, LV_FLEX_FLOW_ROW);
  lv_obj_set_flex_align(row, LV_FLEX_ALIGN_CENTER, LV_FLEX_ALIGN_CENTER, LV_FLEX_ALIGN_CENTER);
  lv_obj_align(row, LV_ALIGN_BOTTOM_MID, 0, -28);
  lv_obj_clear_flag(row, LV_OBJ_FLAG_CLICKABLE);

  for (int i = 0; i < SCREEN_COUNT; i++) {
    dots[i] = lv_obj_create(row);
    lv_obj_set_size(dots[i], 8, 8);
    lv_obj_set_style_radius(dots[i], LV_RADIUS_CIRCLE, 0);
    lv_obj_set_style_border_width(dots[i], 0, 0);
    lv_obj_clear_flag(dots[i], LV_OBJ_FLAG_CLICKABLE);
  }
  update_dots(0);
}

// ============================================================
//  Data binding
// ============================================================
static void refresh_cb(lv_timer_t *t)
{
  // Ignition self-test runs first; alerts and live data wait until it's done.
  static bool booting = true;
  if (booting) {
    booting = boot_sequence();
    if (booting) return;
  }

  if (!dataProvider) return;
  GaugeData d;
  dataProvider(&d);

  // --- Fuel (Störk dial): both needle ends on hidden permille scales
  // (0 = full, 1000 = empty), kept 180° apart ---
  int fuelV = 1000 - (int)(d.fuelPct * 10.0f + 0.5f);
  if (fuelV < 0) fuelV = 0; else if (fuelV > 1000) fuelV = 1000;
  lv_meter_set_indicator_value(fuelMeter, fuelNeedleL, fuelV);
  lv_meter_set_indicator_value(fuelMeter, fuelNeedleR, fuelV);
  lv_label_set_text_fmt(fuelDigital, "%d L", (int)(d.fuelPct * FUEL_TANK_LITERS / 100.0f + 0.5f));

  // Low-fuel alert swaps in for the digital % (guarded: don't re-invalidate)
  bool low = d.fuelPct < FUEL_ALERT_BELOW;
  if (low == lv_obj_has_flag(fuelAlert, LV_OBJ_FLAG_HIDDEN)) {
    if (low) {
      lv_obj_clear_flag(fuelAlert, LV_OBJ_FLAG_HIDDEN);
      lv_obj_add_flag(fuelDigital, LV_OBJ_FLAG_HIDDEN);
      jump_to_tile(TILE_FUEL);
    } else {
      lv_obj_add_flag(fuelAlert, LV_OBJ_FLAG_HIDDEN);
      lv_obj_clear_flag(fuelDigital, LV_OBJ_FLAG_HIDDEN);
    }
  }

  // Blink the headlight-eyes while the alert is up: 400 ms on / 400 ms off
  // (refresh runs every 100 ms), only touching styles on actual transitions.
  if (low) {
    static uint8_t blinkTick = 0;
    static bool lampsOn = false;
    bool on = ((++blinkTick / 4) & 1) != 0;
    if (on != lampsOn) {
      lampsOn = on;
      lv_obj_set_style_opa(fuelEyeL, on ? LV_OPA_COVER : LV_OPA_TRANSP, 0);
      lv_obj_set_style_opa(fuelEyeR, on ? LV_OPA_COVER : LV_OPA_TRANSP, 0);
    }
  }

  // --- Speed (VDO speedometer) ---
  int mph = (int)(d.speedMph + 0.5f);
  lv_meter_set_indicator_value(speedMeter, speedNeedle, mph > 80 ? 80 : mph);
  lv_label_set_text_fmt(speedDigital, "%d", mph);
  lv_label_set_text_fmt(speedSats, "%d sats · %s", d.sats, d.fix ? "fix" : "no fix");

  // --- Volts (VDO voltmeter) ---
  int v10 = (int)(d.battV * 10.0f + 0.5f);
  int vNeedle = v10 < 80 ? 80 : (v10 > 160 ? 160 : v10);   // needle stays on the 8–16 scale
  lv_meter_set_indicator_value(voltMeter, voltNeedle, vNeedle);
  lv_label_set_text_fmt(voltDigital, "%d.%d", v10 / 10, v10 % 10);
  lv_obj_set_style_text_color(voltDigital, lv_color_hex(volt_text_color(d.battV)), 0);

  // LOW VOLTAGE alert — ignored during the first minute (startup sag)
  bool vlow = d.battV < VOLT_ALERT_BELOW && millis() > VOLT_ALERT_STARTUP_MS;
  if (vlow == lv_obj_has_flag(voltAlert, LV_OBJ_FLAG_HIDDEN)) {
    if (vlow) {
      lv_obj_clear_flag(voltAlert, LV_OBJ_FLAG_HIDDEN);
      jump_to_tile(TILE_VOLTS);
    } else {
      lv_obj_add_flag(voltAlert, LV_OBJ_FLAG_HIDDEN);
    }
  }

  // --- Clock (VDO dash clock) ---
  lv_label_set_text(clockValue, d.clock);
  lv_label_set_text(clockSub, d.fix ? "GPS time" : "waiting for GPS time");
  if (d.clock[0] >= '0' && d.clock[0] <= '9') {
    int hh = (d.clock[0] - '0') * 10 + (d.clock[1] - '0');
    int mm = (d.clock[3] - '0') * 10 + (d.clock[4] - '0');
    lv_meter_set_indicator_value(clockMeter, clockMinHand, mm);
    lv_meter_set_indicator_value(clockMeter, clockHourHand, (hh % 12) * 60 + mm);
  }

  // --- Compass (direction indicator) ---
  // Card angle = -heading, in LVGL 0.1° units. Skip the (expensive) rotation
  // redraw entirely when the heading hasn't moved.
  int hdg = (int)(d.headingDeg + 0.5f) % 360;
  static int lastAngle = -1;
  int angle = (3600 - (int)(d.headingDeg * 10.0f + 0.5f) % 3600) % 3600;
  if (angle != lastAngle) {
    lastAngle = angle;
    lv_img_set_angle(compassCard, angle);
  }
  int card = ((int)((d.headingDeg + 22.5f) / 45.0f)) % 8;
  lv_label_set_text_fmt(compassReadout, "%d° %s", hdg, CARDINALS[card]);

  // --- Brakes tile: circuit lamps + verdict ---
  uint32_t c1 = (d.brakeFault == BRAKE_FAULT_C1) ? COL_RED
              : (d.brake1 ? COL_YELLOW : COL_HUB_DARK);
  uint32_t c2 = (d.brakeFault == BRAKE_FAULT_C2) ? COL_RED
              : (d.brake2 ? COL_YELLOW : COL_HUB_DARK);
  lv_obj_set_style_bg_color(brakeLamp1, lv_color_hex(c1), 0);
  lv_obj_set_style_bg_color(brakeLamp2, lv_color_hex(c2), 0);
  if (d.brakeFault != BRAKE_FAULT_NONE) {
    lv_obj_set_style_bg_color(brakeVerdict, lv_color_hex(COL_RED), 0);
    lv_label_set_text(brakeVerdictLabel, "NOT OK");
    lv_label_set_text_fmt(brakeSubLabel, "C%d FAILED", d.brakeFault);
    lv_obj_set_style_text_color(brakeSubLabel, lv_color_hex(COL_RED), 0);
  } else {
    lv_obj_set_style_bg_color(brakeVerdict, lv_color_hex(COL_GREEN), 0);
    lv_label_set_text(brakeVerdictLabel, "OK");
    lv_label_set_text(brakeSubLabel, "press pedal to test");
    lv_obj_set_style_text_color(brakeSubLabel, lv_color_hex(COL_FAINT), 0);
  }

  // --- Brake fault alert (V4) — outranks everything on the display ---
  brake_sync(d);
}

// ============================================================
void Gauge_UI_Init(gauge_data_provider_t provider)
{
  dataProvider = provider;

  lv_obj_set_style_bg_color(lv_scr_act(), lv_color_hex(COL_BG), 0);

  tileview = lv_tileview_create(lv_scr_act());
  lv_obj_set_size(tileview, LV_HOR_RES, LV_VER_RES);
  lv_obj_set_style_bg_color(tileview, lv_color_hex(COL_BG), 0);
  lv_obj_set_scrollbar_mode(tileview, LV_SCROLLBAR_MODE_OFF);
  lv_obj_add_event_cb(tileview, tile_changed_cb, LV_EVENT_VALUE_CHANGED, NULL);

  build_fuel(make_tile(0));
  build_speed(make_tile(1));
  build_volts(make_tile(2));
  build_clock(make_tile(3));
  build_compass(make_tile(4));
  build_brakes(make_tile(5));
  build_dots();
  build_brake_alert();   // after the dots: same top layer, must cover them
  build_splash();        // topmost: visible from the first frame

  lv_timer_create(refresh_cb, 100, NULL);   // ~10 Hz UI refresh from the data provider
}
