Xilly-the-Honorable/beetledash/(commit log)

2026-08-07 V2 M1: panel bring-up - ST7701 RGB + CST820 touch + LVGL 8.3 from Waveshare official demo, I2C bus mutex for cross-core sharing
2026-08-07 V2 M2: port V1 sensors + WiFi dashboard into core-0 task with thread-safe GaugeData snapshot
2026-08-07 V2 M5: smart heading (GPS course when moving), 5 Hz GPS rate command (UBX+PMTK), IST8310 support, 2x zoomed gauge digits
2026-08-07 Docs: V2 flash guide (offline LVGL install), fix stale bench fuel-resistor table, record as-built V2 details in PROJECT_CONTEXT
2026-08-10 V3 M1: shared 1965 VDO style pass - chrome bezel, matte face, cream/sage palette, wordmark, restyled page dots
    [BeetleDash_V2_display.ino, Gauge_UI.cpp]
2026-08-10 V3 M3: Volts restyled as VDO voltmeter - banded 8-16V arc scale + live digital readout under the hub
2026-08-10 V3 M4: Speed restyled as 1965 VDO speedometer - 0-80 sage numerals, silver hub, small digital mph
    [Gauge_UI.cpp]
2026-08-10 V3 M5: Compass restyled as aviation direction indicator - PSRAM canvas card rotated via lv_img_set_angle, fixed orange beetle icon + lubber line
    [Gauge_UI.cpp]
2026-08-15 V4 M1: brake circuit sampling on ADS A2/A3 - hysteresis switch states in GaugeData, Serial + /data JSON, PROJECT_CONTEXT 5 wiring spec (monitor gated off until dividers wired)
2026-08-15 V4 M2: brake fault logic - XOR + 1s debounce + latch (unit-testable), thread-safe clear request, demo-mode staged C1 fault
2026-08-15 V4 M3: brake alert UI - top-layer full-screen overlay (blinking red ring, tap to acknowledge), persistent banner with 3s long-press clear, phone dashboard fault banner
2026-08-15 V4 M4: sixth BRAKES tile - C1/C2 idiot lights (lit on pedal press), OK/NOT-OK verdict lamp, page dots now 6
2026-08-18 Fuel: tank capacity 40 L
2026-08-18 Add low-voltage alert feature: Introduced VOLTS LOW alert display with lightning mascot, suppressed during startup. Updated battery voltage simulation to demonstrate alert functionality.
2026-08-18 Volts: low-voltage alert under 10V with 60s startup suppression - yellow panel, lightning-struck beetle mascot
2026-08-19 Alerts auto-jump to their gauge: fuel/volts alerts switch tiles on rising edge, brake fault lands on BRAKES tile under the overlay
2026-08-19 Clock: Kienzle-style face - sage ring band, 12/3/6/9 numerals, square hour markers, brass hands, digital HH:MM in the 8-TAGE spot
    [Gauge_UI.cpp]
2026-08-19 Clock: pre-rendered Kienzle face bitmap (sideways 3/9, deco numerals); fix png2lvgl alpha loss on 24bpp PNGs
    [Gauge_UI.cpp]
2026-08-19 V2.2: LOW FUEL / LOW VOLTAGE wording, yellow panel on fuel alert, fix mascot transparency (24bpp alpha-loss regen)
    [BeetleDash_V2_display.ino, Gauge_UI.cpp]
